kubafilinger/uv-lamp/doc/pcb-switches-board.jpg

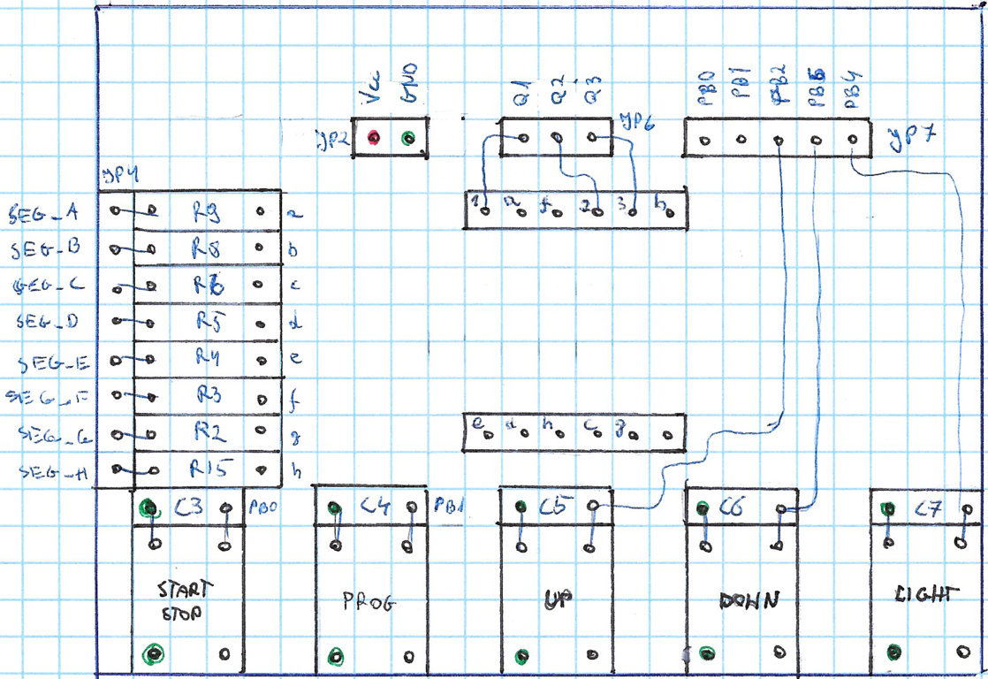
doc/pcb-switches-board.jpg
