kubafilinger/uv-lamp/doc/paznokcie-uv.png

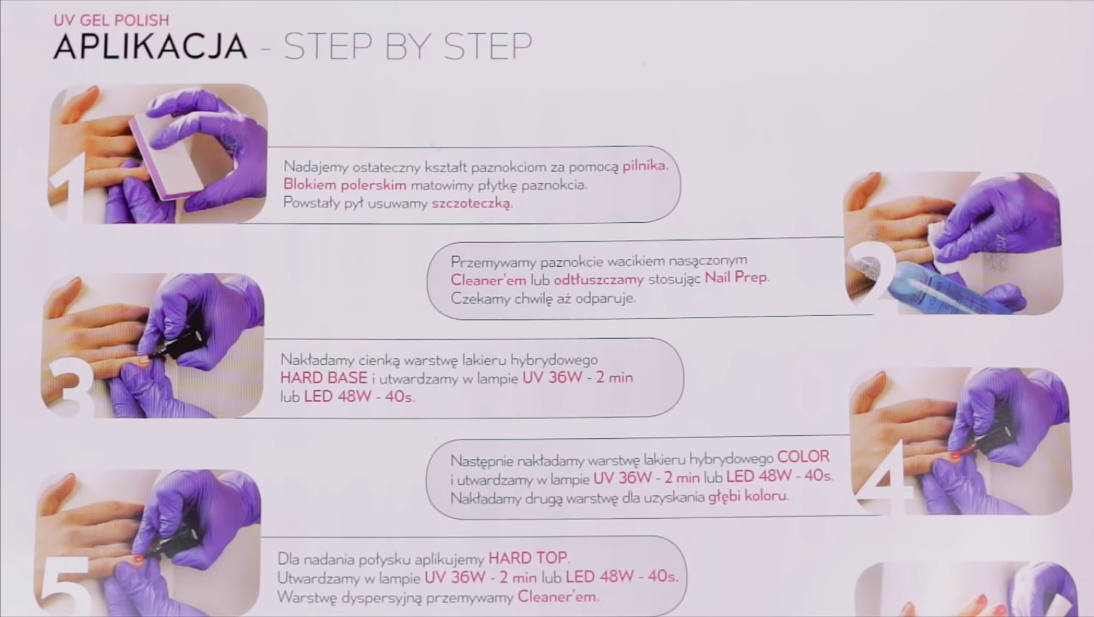
doc/paznokcie-uv.png
