kubafilinger/uv-lamp/doc/pcb-mainboard.jpg

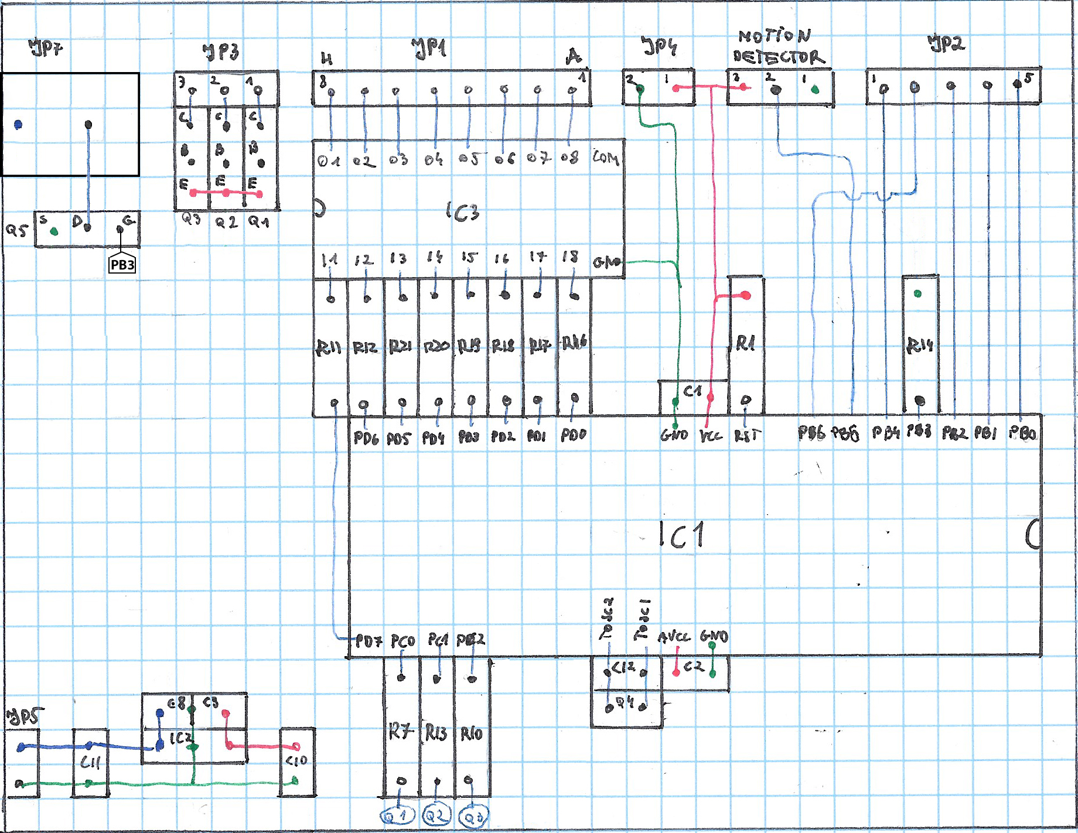
doc/pcb-mainboard.jpg
