kubafilinger/uv-lamp/doc/schema-mainboard.png

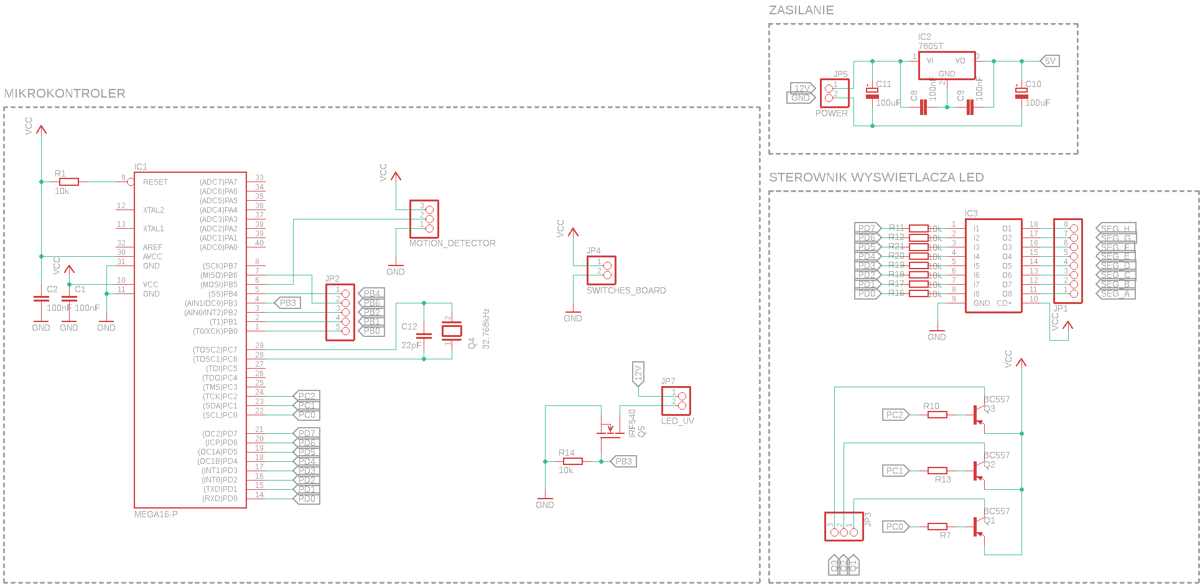
doc/schema-mainboard.png
