kubafilinger/uv-lamp/doc/schema-switches.png

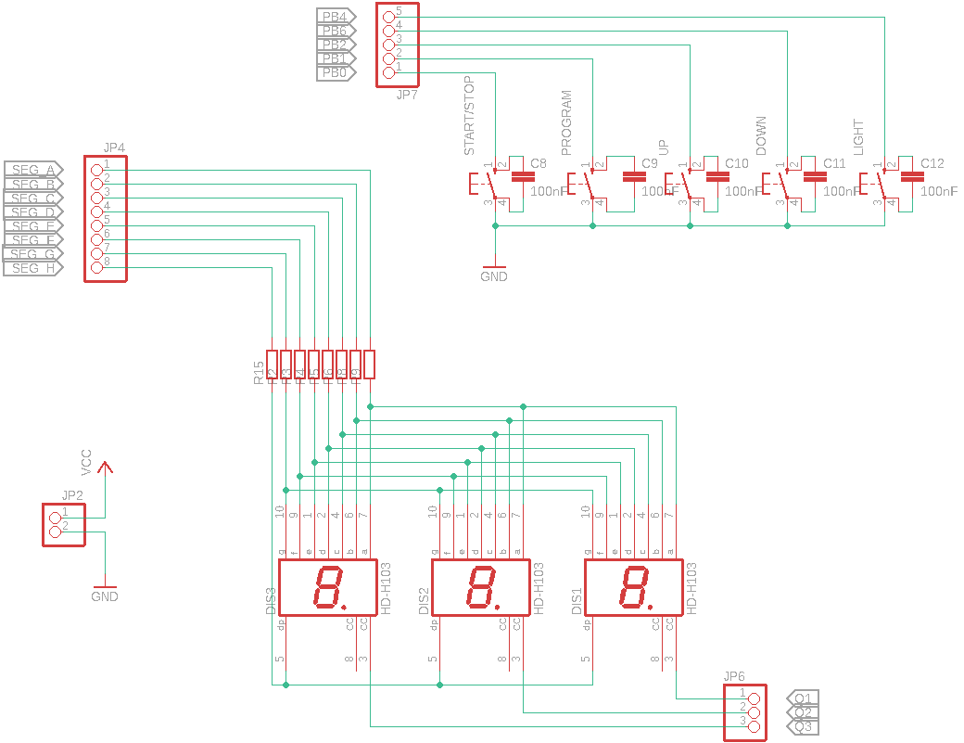
doc/schema-switches.png
