kubafilinger/uv-lamp/3d-print/in-case.stl

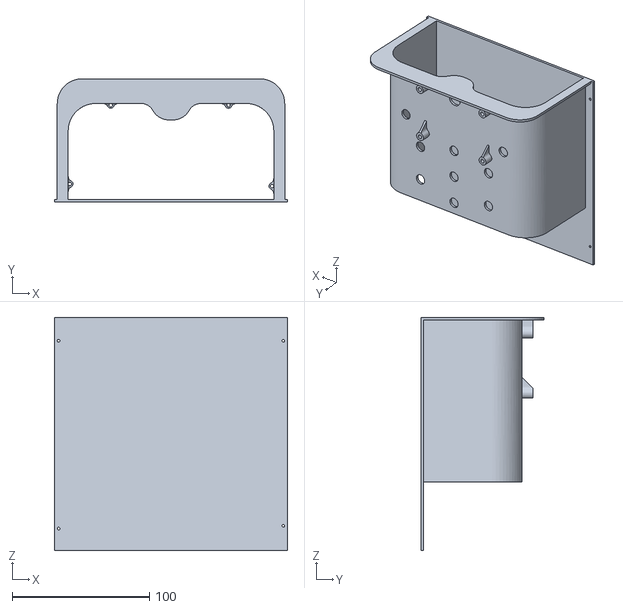
[picture p6: CAD file, 2019-01-01]
3d-print/in-case.stl
170.0 x 90.0 x 170.0
