kubafilinger/uv-lamp/3d-print/electronic.stl

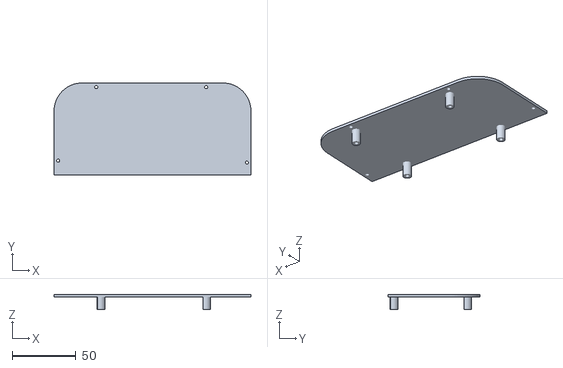
[picture p7: CAD file, 2019-01-01]
3d-print/electronic.stl
154.0 x 72.0 x 12.0
