kubafilinger/uv-lamp/3d-print/out-case.stl

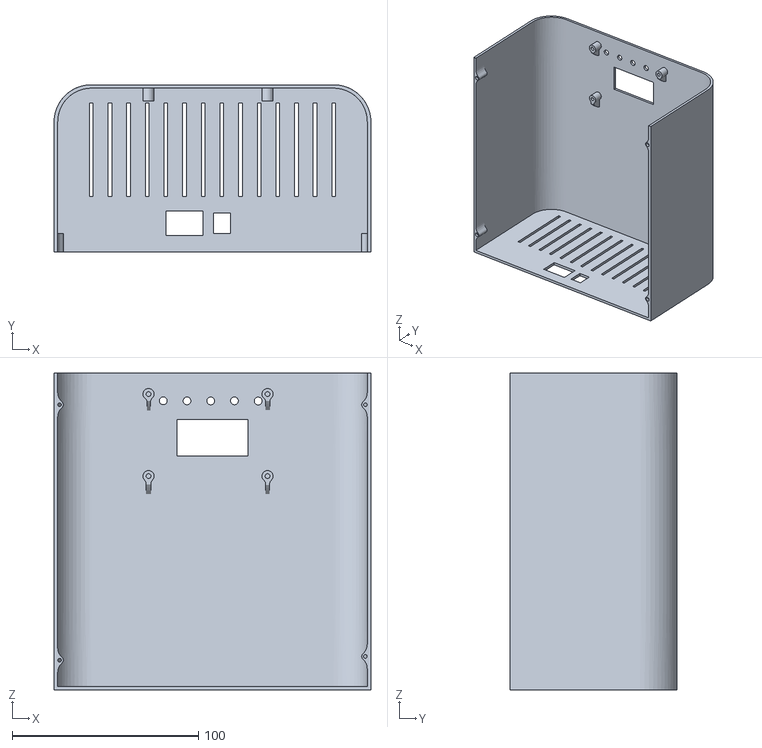
[picture p8: CAD file, 2019-01-01]
3d-print/out-case.stl
170.0 x 89.8 x 170.0
