kubafilinger/uv-lamp/eagle/led_uv.sch

## EAGLE design eagle/led_uv.sch (2019-01-06)

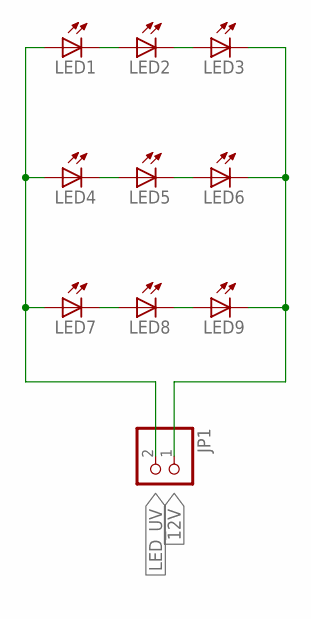
[picture p9: schematic led_uv.sch]

Parts:
JP1: PINHD-1X2; 1X02
LED1, LED2, LED3, LED4, LED5, LED6, LED7, LED8, LED9: W49180; Z-POWER-LED-DOME-TYPE

Connections:
12V: JP1.1, LED3.C, LED6.C, LED9.C
LED_UV: JP1.2, LED1.A, LED4.A, LED7.A
unnamed: LED1.C, LED2.A
unnamed: LED2.C, LED3.A
unnamed: LED8.C, LED9.A
unnamed: LED7.C, LED8.A
unnamed: LED5.C, LED6.A
unnamed: LED4.C, LED5.A
