kubafilinger/uv-lamp/src/led.c

#include "led.h"
/*
void enableLedUv()
{
	*PORT_LED_UV |= (1 << LED_UV_1) | (1 << LED_UV_2) | (1 << LED_UV_3);
}

void disableLedUv()
{
	*PORT_LED_UV &= ~((1 << LED_UV_1) | (1 << LED_UV_2) | (1 << LED_UV_3));
}*/
