kubafilinger/uv-lamp/(commit log)

2019-01-01 Add 3d print project
    [electronic.stl, in-case.stl, out-case.stl]
2019-01-06 [ELECTRONIC] Add eagle schemes and update gitignore
    [led_uv.sch, mainboard.sch, switches_schema.sch]
2019-03-04 [STATIC] Switches pcb
